HuYingTran/Mobile-robot-builds-map/README.md

# Mobile-robot-builds-map

Mô hình robot xây dựng bản đồ sử dụng thiết bị cảm biến khoảng cách và encoder ( dựa trên phương thức hoạt động tương tự lidar)

Xử lý tín hiệu nhiễu của cảm biến laser bằng Low Pass Filter .Mục đích loại bỏ các tín hiệu nhiễu có tần số cao từ môi trường



Dùng bộ lọc Kalman Filter cho xung tín hiệu của Encoder



Công thức chuyển đổi thông số các senser thành vị trí vật cản



Kết quả bản đồ thu được
