HuYingTran/Mobile-robot-builds-map/code_test_BoLoc/xuLy_soLieu.xlsx

Times | 1 | 2 | 3 | 4 | 5 | Average | Erorr |  | Times | 1 | 2 | 3 | 4 | 5 | Average | Erorr
20 | 29 | 27 | 27 | 28 | 30 | 28.2 | 8.2 | 0 | 20 | 22 | 23 | 22 | 21 | 23 | 22.2 | 2.2
50 | 54 | 52 | 51 | 49 | 51 | 51.4 | 1.4 | 0 | 50 | 54 | 52 | 51 | 49 | 51 | 51.4 | 1.4
100 | 110 | 113 | 113 | 111 | 110 | 111.4 | 11.4 | 0 | 100 | 104 | 106 | 99 | 101 | 105 | 103 | 3
150 | 158 | 159 | 161 | 159 | 162 | 159.8 | 9.8 | 0 | 150 | 155 | 152 | 151 | 154 | 155 | 153.4 | 3.4
200 | 213 | 212 | 212 | 213 | 211 | 212.2 | 12.2 | 0 | 200 | 206 | 202 | 201 | 203 | 205 | 203.4 | 3.4
250 | 265 | 270 | 266 | 268 | 264 | 266.6 | 16.6 | 0 | 250 | 255 | 253 | 250 | 251 | 257 | 253.2 | 3.2
300 | 319 | 215 | 316 | 320 | 313 | 296.6 | -3.4 | 0 | 300 | 302 | 302 | 308 | 302 | 305 | 303.8 | 3.8
350 | 359 | 366 | 364 | 363 | 361 | 362.6 | 12.6 | 0 | 350 | 356 | 356 | 351 | 352 | 355 | 354 | 4
400 | 416 | 419 | 417 | 421 | 415 | 417.6 | 17.6 | 0 | 400 | 406 | 409 | 403 | 401 | 406 | 405 | 5
450 | 466 | 468 | 470 | 468 | 465 | 467.4 | 17.4 | 0 | 450 | 456 | 453 | 451 | 453 | 454 | 453.4 | 3.4
500 | 518 | 521 | 517 | 520 | 516 | 518.4 | 18.4 | 0 | 500 | 502 | 501 | 503 | 501 | 506 | 502.6 | 2.6
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
